SheshkoKonstantin/clunet-switch1/img/5.JPG

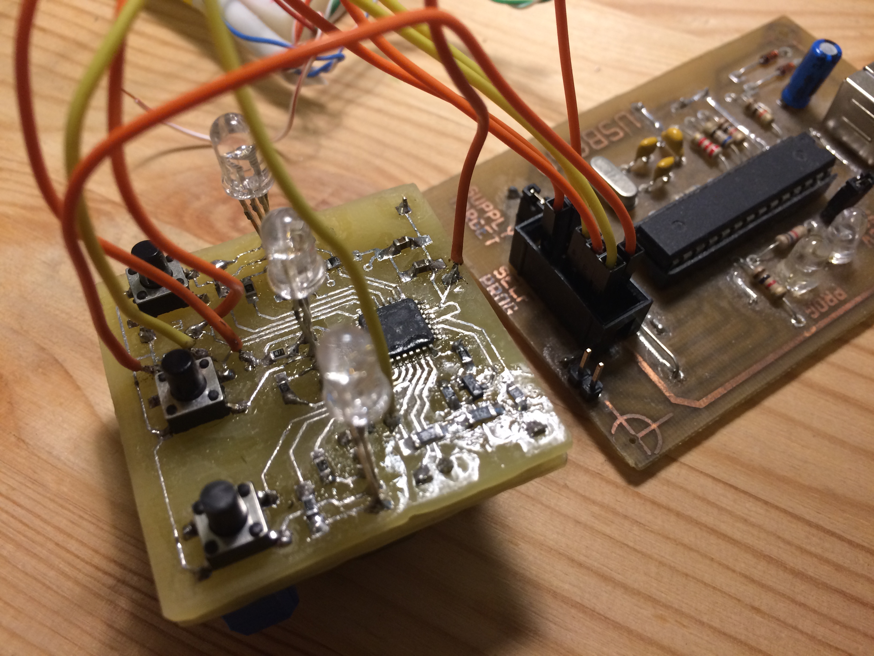
img/5.JPG
