SheshkoKonstantin/clunet-switch1/img/2.JPG

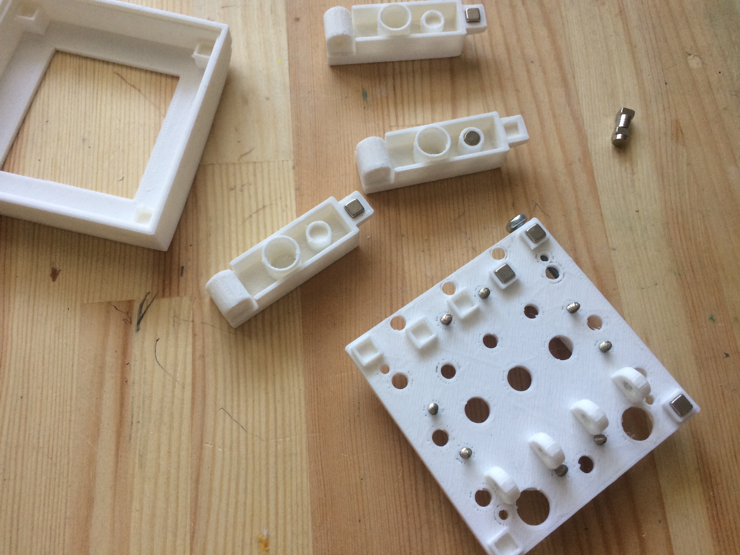
img/2.JPG
