SheshkoKonstantin/clunet-switch1/img/1.JPG

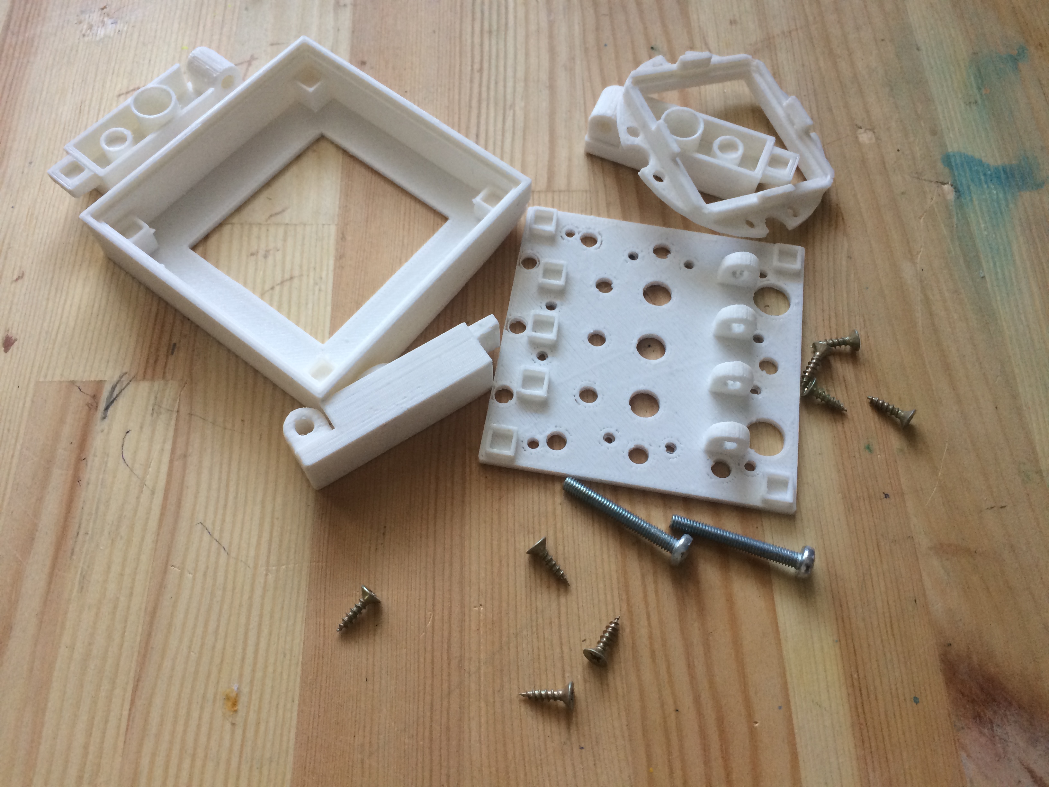
img/1.JPG
