SheshkoKonstantin/clunet-switch1/img/3.JPG

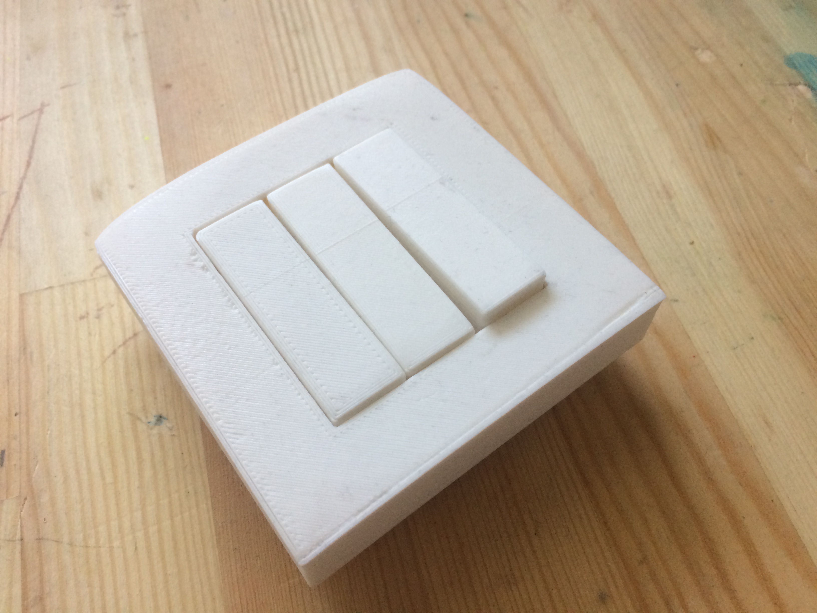
img/3.JPG
