SheshkoKonstantin/clunet-switch1/img/4.JPG

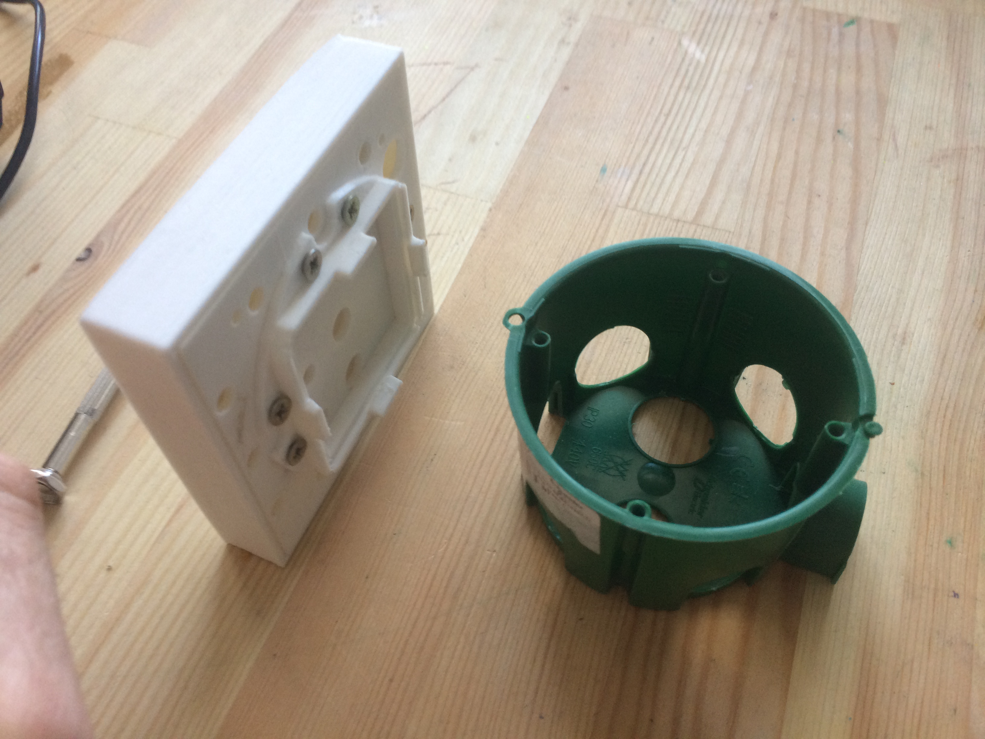
img/4.JPG
