SheshkoKonstantin/clunet-switch1/img/6.JPG

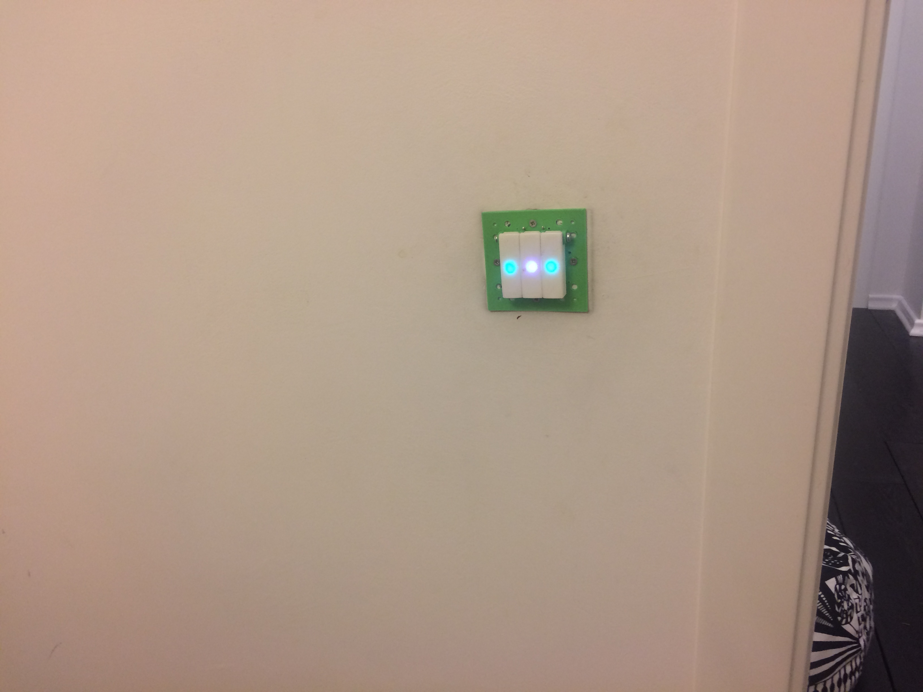
img/6.JPG
