SheshkoKonstantin/clunet-switch1/img/7.JPG

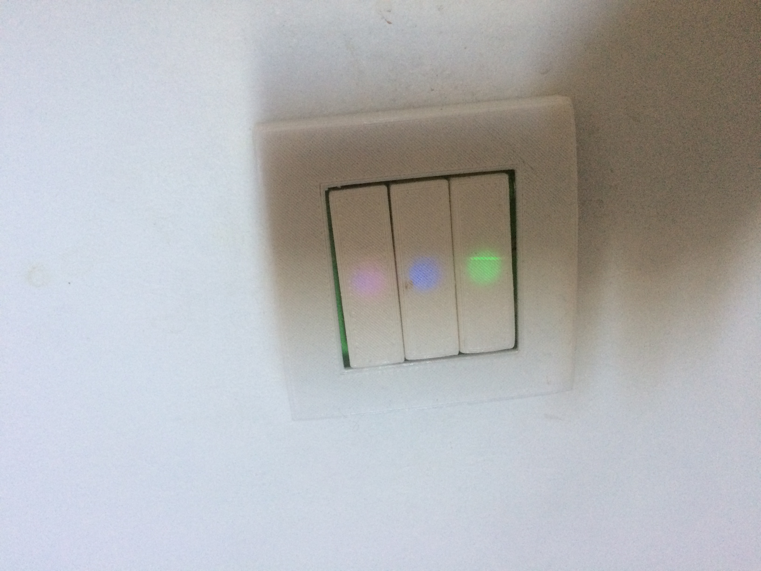
img/7.JPG
