SheshkoKonstantin/clunet-switch1/(list of files, cad)

Other CAD files:
blender/korpus1.blend
