SheshkoKonstantin/clunet-switch1/img/pcb.pdf

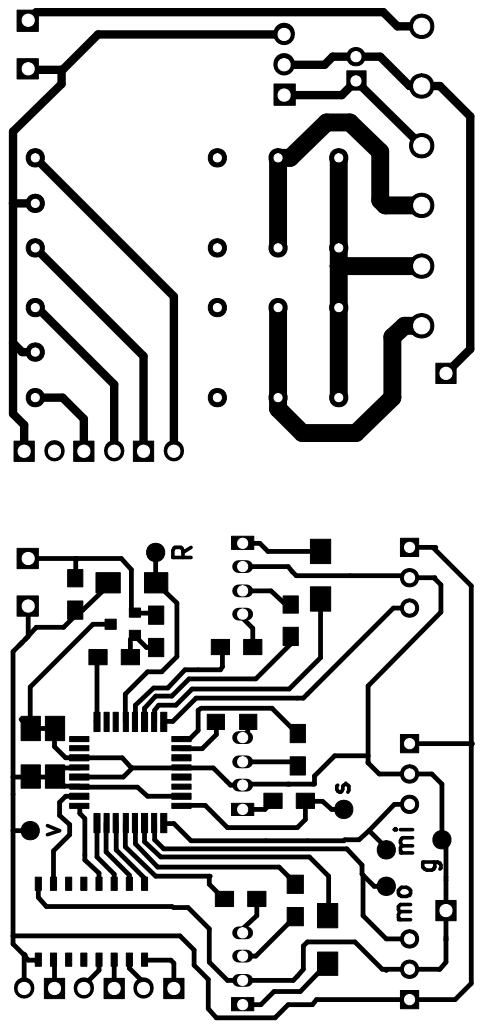
[picture p8: page 1]
