SheshkoKonstantin/clunet-switch1/img/sch.pdf

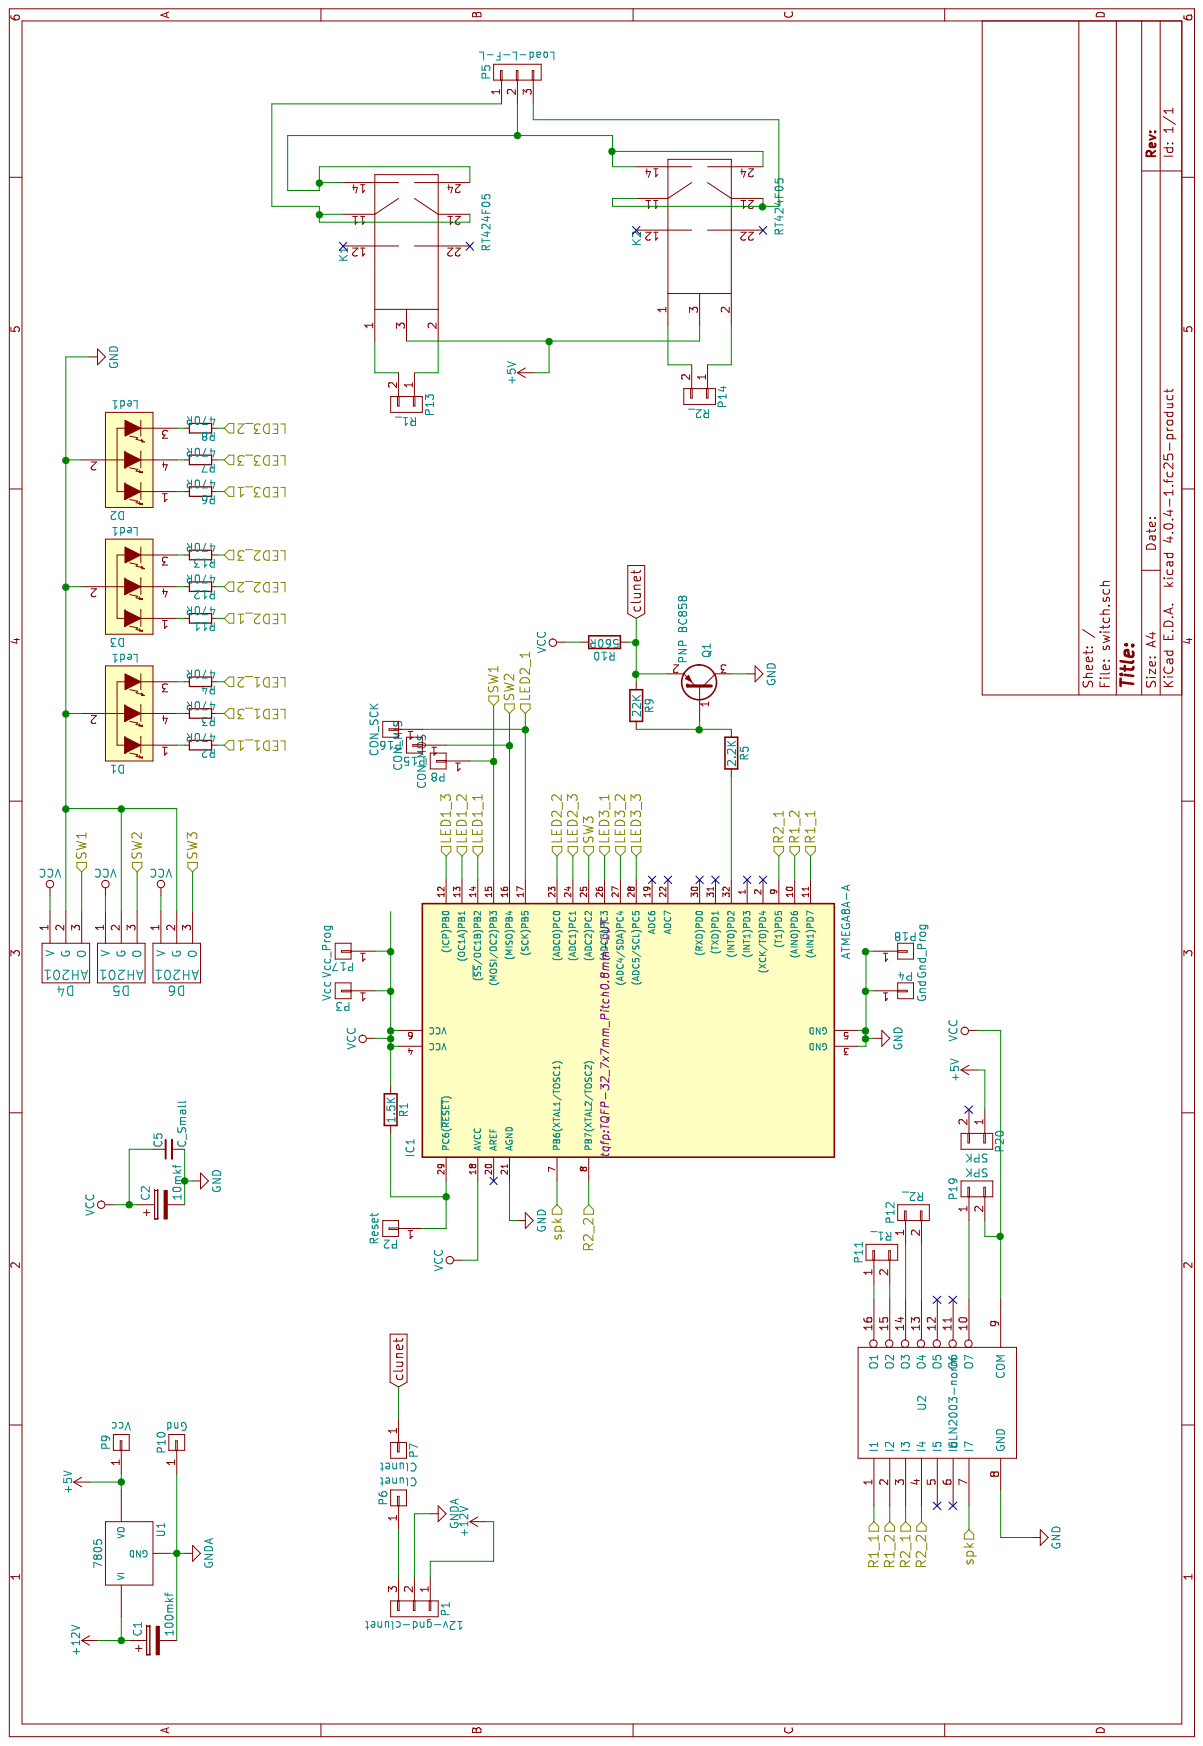
[picture p9: page 1]
