SheshkoKonstantin/clunet-switch1/schema/switch.kicad_pcb

## KiCad design schema/switch.kicad_pcb (2017-03-24)

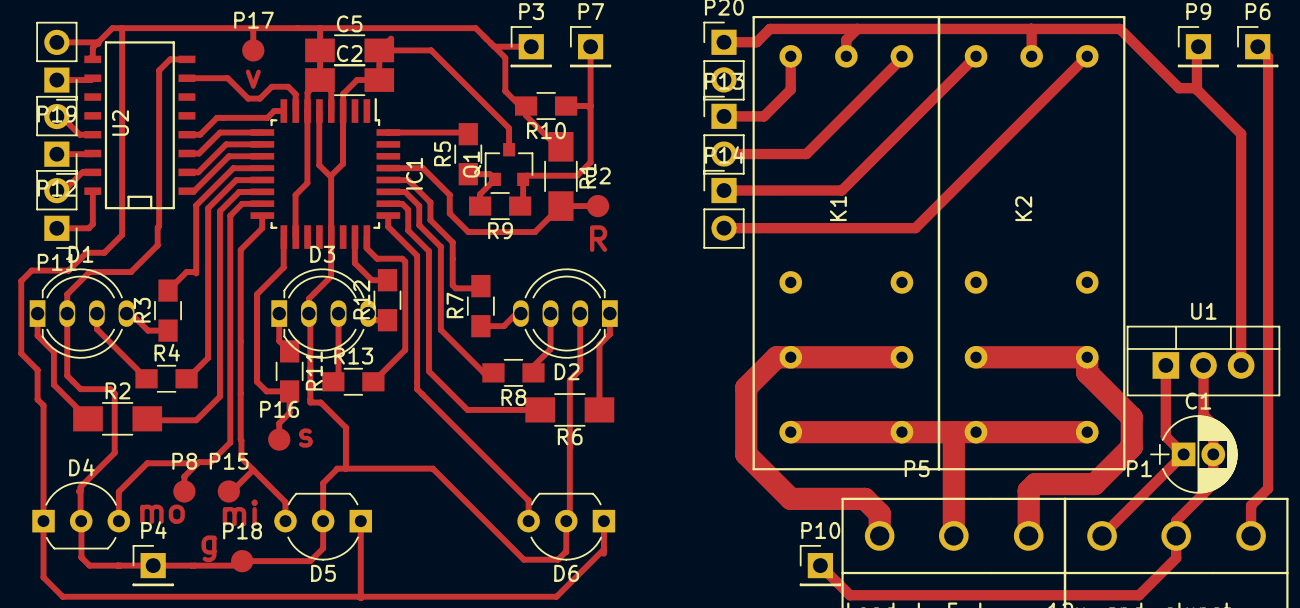
[picture p10: board switch.kicad_pcb from above]

Board: 2 copper layers, 48 parts (0 on the bottom side), 48 nets.

Parts:
C1: 100mkf; CP_Radial_D5.0mm_P2.00mm
C2: 10mkf; C_1206_HandSoldering
C5: C_Small; C_1206_HandSoldering
D1, D2, D3: Led1; LED_D5.0mm-4-LL
D4, D5, D6: AH201; TO-92_Inline_Wide
IC1: ATMEGA8A-A; TQFP-32_7x7mm_Pitch0.8mm-LUT
K1, K2: RT424F05
P1: 12v-gnd-clunet; DG301-5.0-3x
P2: Reset; Measurement_Point_Round-SMD-Pad_Small
P3, P9: Vcc; Socket_Strip_Straight_1x01_Pitch2.54mm
P4, P10: Gnd; Socket_Strip_Straight_1x01_Pitch2.54mm
P5: Load-L-F-L; DG301-5.0-3x
P6, P7: Clunet; Socket_Strip_Straight_1x01_Pitch2.54mm
P8: CON_MOS; Measurement_Point_Round-SMD-Pad_Small
P11, P13: R1_; Socket_Strip_Straight_1x02_Pitch2.54mm
P12, P14: R2_; Socket_Strip_Straight_1x02_Pitch2.54mm
P15: CON_MIS; Measurement_Point_Round-SMD-Pad_Small
P16: CON_SCK; Measurement_Point_Round-SMD-Pad_Small
P17: Vcc_Prog; Measurement_Point_Round-SMD-Pad_Small
P18: Gnd_Prog; Measurement_Point_Round-SMD-Pad_Small
P19, P20: SPK; Socket_Strip_Straight_1x02_Pitch2.54mm
Q1: PNP BC858; SOT-23
R1: 1.5K; R_1206_HandSoldering
R2, R6: 470R; R_1206_HandSoldering
R3, R4, R7, R8, R11, R12, R13: 470R; R_0805_HandSoldering
R5: 2.2K; R_0805_HandSoldering
R9: 22K; R_0805_HandSoldering
R10: 560R; R_0805_HandSoldering
U1: 7805; TO-220_Vertical-LM7805
U2: ULN2003-norm; SO-16-N

Connections:
+5V: K1.3, K2.3, P9.1, P20.1, U1.VO
+12V: C1.1, P1.1, U1.VI
/LED1_1: IC1.14, R2.2
/LED1_2: IC1.13, R4.2
/LED1_3: IC1.12, R3.2
/LED2_1: IC1.17, P16.1, R11.2
/LED2_2: IC1.23, R12.2
/LED2_3: IC1.24, R13.2
/LED3_1: IC1.26, R6.2
/LED3_2: IC1.27, R8.2
/LED3_3: IC1.28, R7.2
/R1_1: IC1.11, U2.1
/R1_2: IC1.10, U2.2
/R2_1: IC1.9, U2.3
/R2_2: IC1.8, U2.4
/SW1: D4.3, IC1.15, P8.1
/SW2: D5.3, IC1.16, P15.1
/SW3: D6.3, IC1.25
/spk: IC1.7, U2.7
GND: C2.2, C5.2, D1.2, D2.2, D3.2, D4.2, D5.2, D6.2, IC1.3, IC1.5, IC1.21, P4.1, P18.1, Q1.3, U2.8
GNDA: C1.2, P1.2, P10.1, U1.GND
unnamed: D1.1, R2.1
unnamed: D1.3, R4.1
unnamed: D1.4, R3.1
unnamed: D2.1, R6.1
unnamed: D2.3, R8.1
unnamed: D2.4, R7.1
unnamed: D3.1, R11.1
unnamed: D3.3, R13.1
unnamed: D3.4, R12.1
unnamed: IC1.29, P2.1, R1.2
unnamed: IC1.32, R5.2
unnamed: K1.1, P13.2
unnamed: K1.2, P13.1
unnamed: K1.11, K1.21, P5.1
unnamed: K1.14, K1.24, K2.14, K2.24, P5.2
unnamed: K2.1, P14.2
unnamed: K2.2, P14.1
unnamed: K2.11, K2.21, P5.3
unnamed: P1.3, P6.1
unnamed: P11.1, U2.16
unnamed: P11.2, U2.15
unnamed: P12.1, U2.14
unnamed: P12.2, U2.13
unnamed: P19.1, U2.10
unnamed: Q1.1, R5.1, R9.2
VCC: C2.1, C5.1, D4.1, D5.1, D6.1, IC1.4, IC1.6, IC1.18, P3.1, P17.1, P19.2, R1.1, R10.2, U2.9
clunet: P7.1, Q1.2, R9.1, R10.1
