SheshkoKonstantin/clunet-switch1/clunet_config.h

/**************************************************************************************
The MIT License (MIT)
Copyright (c) 2016 Sergey V. DUDANOV
Permission is hereby granted, free of charge, to any person obtaining a copy
of this software and associated documentation files (the "Software"), to deal
in the Software without restriction, including without limitation the rights
to use, copy, modify, merge, publish, distribute, sublicense, and/or sell
copies of the Software, and to permit persons to whom the Software is
furnished to do so, subject to the following conditions:
The above copyright notice and this permission notice shall be included in all
copies or substantial portions of the Software.
THE SOFTWARE IS PROVIDED "AS IS", WITHOUT WARRANTY OF ANY KIND, EXPRESS OR
IMPLIED, INCLUDING BUT NOT LIMITED TO THE WARRANTIES OF MERCHANTABILITY,
FITNESS FOR A PARTICULAR PURPOSE AND NONINFRINGEMENT. IN NO EVENT SHALL THE
AUTHORS OR COPYRIGHT HOLDERS BE LIABLE FOR ANY CLAIM, DAMAGES OR OTHER
LIABILITY, WHETHER IN AN ACTION OF CONTRACT, TORT OR OTHERWISE, ARISING FROM,
OUT OF OR IN CONNECTION WITH THE SOFTWARE OR THE USE OR OTHER DEALINGS IN THE
SOFTWARE.
*****************************************************************************************/

#ifndef __CLUNET_CONFIG_H__
#define __CLUNET_CONFIG_H__

/* CONFIGURE YOUR DEVICE HERE */

/* Device address (0-254) */
#define CLUNET_DEVICE_ID 100

/* Device name */
#define CLUNET_DEVICE_NAME "CLUNET device"

/* Buffers sizes (memory usage) */
#define CLUNET_SEND_BUFFER_SIZE 128
#define CLUNET_READ_BUFFER_SIZE 128

/* MCUs pin, external interrupt with any logical change is required! */
#define CLUNET_PORT D
#define CLUNET_PIN 2

/*
	Custom T (T >= 8 && T <= 24).
	T is frame unit size in timer ticks. Lower - faster, higher - more stable.
	If not defined T will be calculated as ~64us based on CLUNET_TIMER_PRESCALER value.
*/
//#define CLUNET_T 8

/* 8-bit Timer/Counter definitions */

// Timer initialization in NORMAL MODE
#define CLUNET_TIMER_INIT { TCCR2 = (1 << CS22); }
// Timer prescaler (for autocalculate T period)
#define CLUNET_TIMER_PRESCALER 64
// Main Register
#define CLUNET_TIMER_REG TCNT2
// Output Compare Register
#define CLUNET_TIMER_REG_OCR OCR2
// Overflow Condition (used in bootloader only)
#define CLUNET_TIMER_OVERFLOW (TIFR & (1 << TOV2))
// Reset Overflow Flag Command (used in bootloader only)
#define CLUNET_TIMER_OVERFLOW_CLEAR { TIFR = (1 << TOV2); }
// Reset Output Compare Flag Command
#define CLUNET_CLEAR_OCF { TIFR = (1 << OCF2); }
// Enable timer compare interrupt (reset output compare flag & enable interrupt)
#define CLUNET_ENABLE_OCI { TIMSK |= (1 << OCIE2); }
// Disable timer compare interrupt
#define CLUNET_DISABLE_OCI { TIMSK &= ~(1 << OCIE2); }

/* End of Timer/Counter definitions */

/* How to init, enable & disable external interrupt (any logical change) */
#define CLUNET_INT_ENABLE { GIFR = (1 << INTF0); GICR |= (1 << INT0); }
#define CLUNET_INT_DISABLE { GICR &= ~(1 << INT0); }
#define CLUNET_INT_INIT { MCUCR |= (1 << ISC00); MCUCR &= ~(1 << ISC01); CLUNET_INT_ENABLE; }

/* Interrupt vectors */
#define CLUNET_TIMER_COMP_VECTOR TIMER2_COMP_vect
#define CLUNET_INT_VECTOR INT0_vect

#endif
