SheshkoKonstantin/clunet-switch1/(commit log)

2017-03-20 Первый комит Здесь уже было много изменений. Пора бы начать репозиторй
    [knopka1.blend, korpus1.blend, switch.kicad_pcb, switch.sch]
2017-03-20 Добавлен КлуНет
2017-03-20 Недостающие файлы схемы
    [switch.sch]
2017-03-21 Изменил тактовые кнопки на датчики Холла
    [switch.kicad_pcb, switch.sch]
2017-03-24 Добавление крышки
    [korpus1.blend, switch.kicad_pcb]
2017-04-09 Какие-то еще небольшие изменения в корпусе Напечатался не плохо
    [knopka1.stl]
2017-04-09 Попытка привести все в порядок
    [knopka1.blend, knopka1.stl, korpus1.blend]
2017-04-09 Фото
2017-04-09 Добавлены схема и разводка в PDF
